forg3/secadora-de-toalha/Esquemático Completo do Secador de Toalhas.png

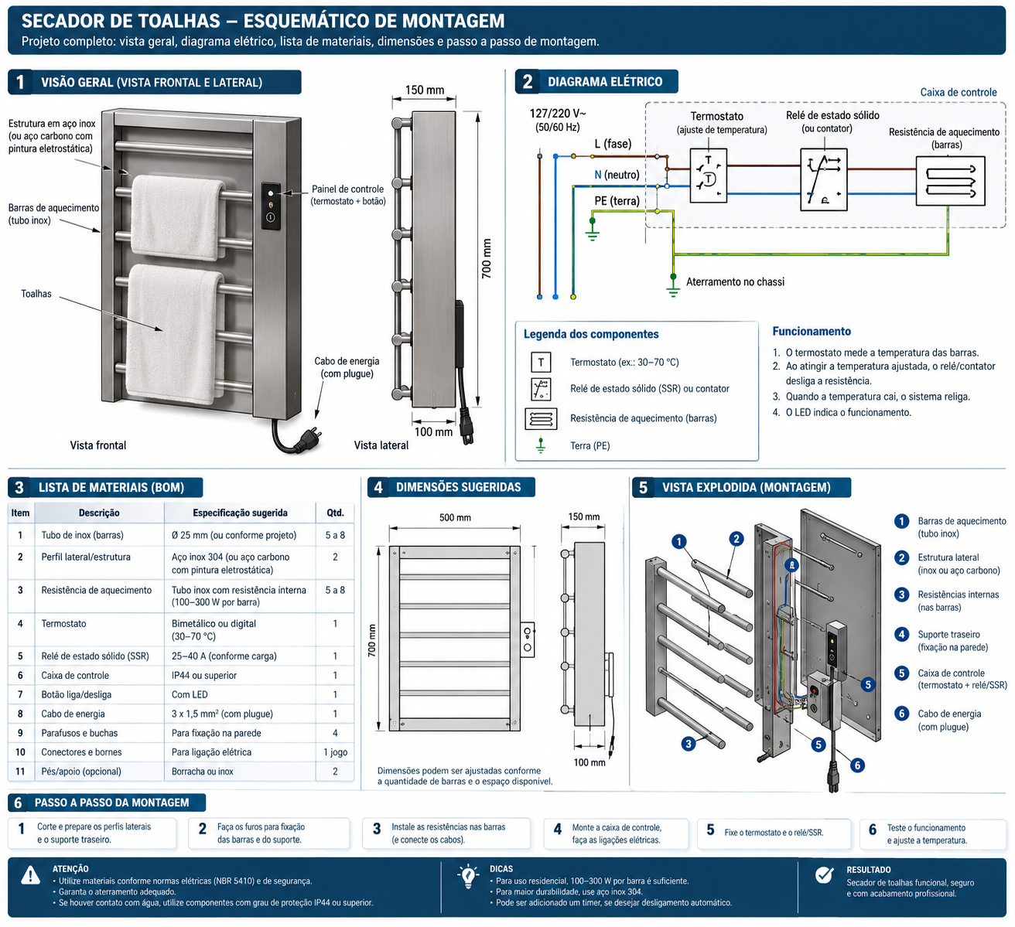
Esquemático Completo do Secador de Toalhas.png
