forg3/secadora-de-toalha/Infográfico Técnico_ Secador de Toalhas.png

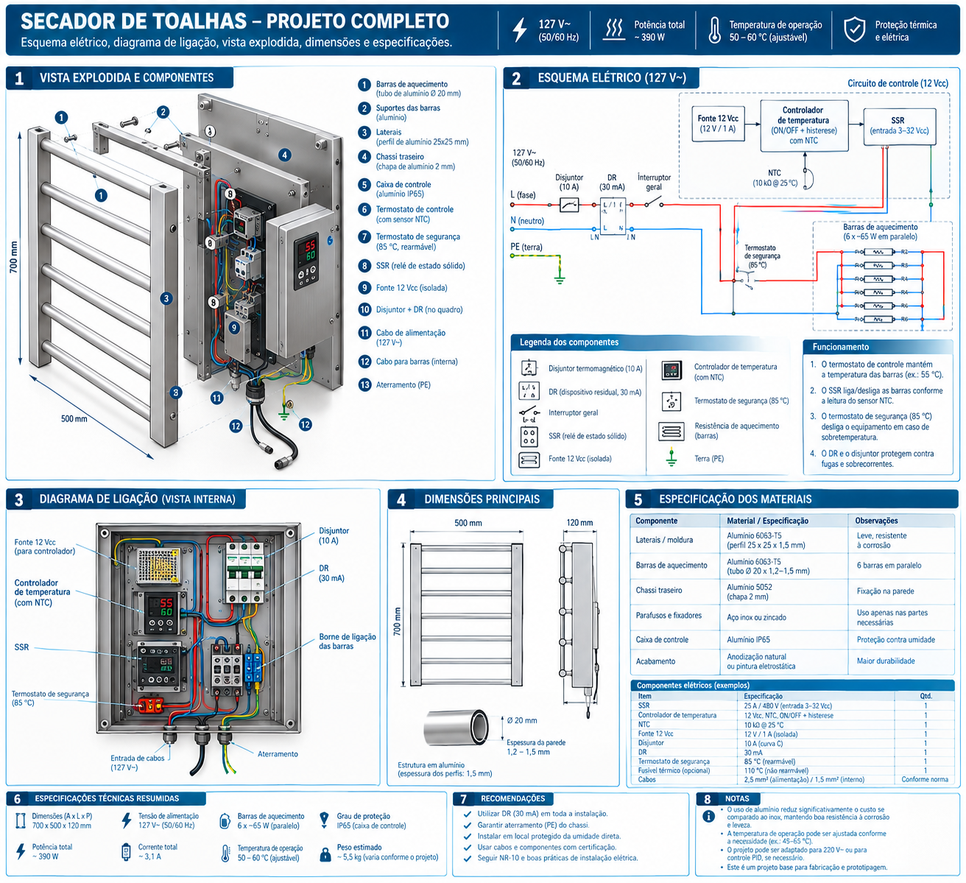
Infográfico Técnico_ Secador de Toalhas.png
