forg3/secadora-de-toalha/ChatGPT Image 12 de set. de 2026, 21_11_23.png

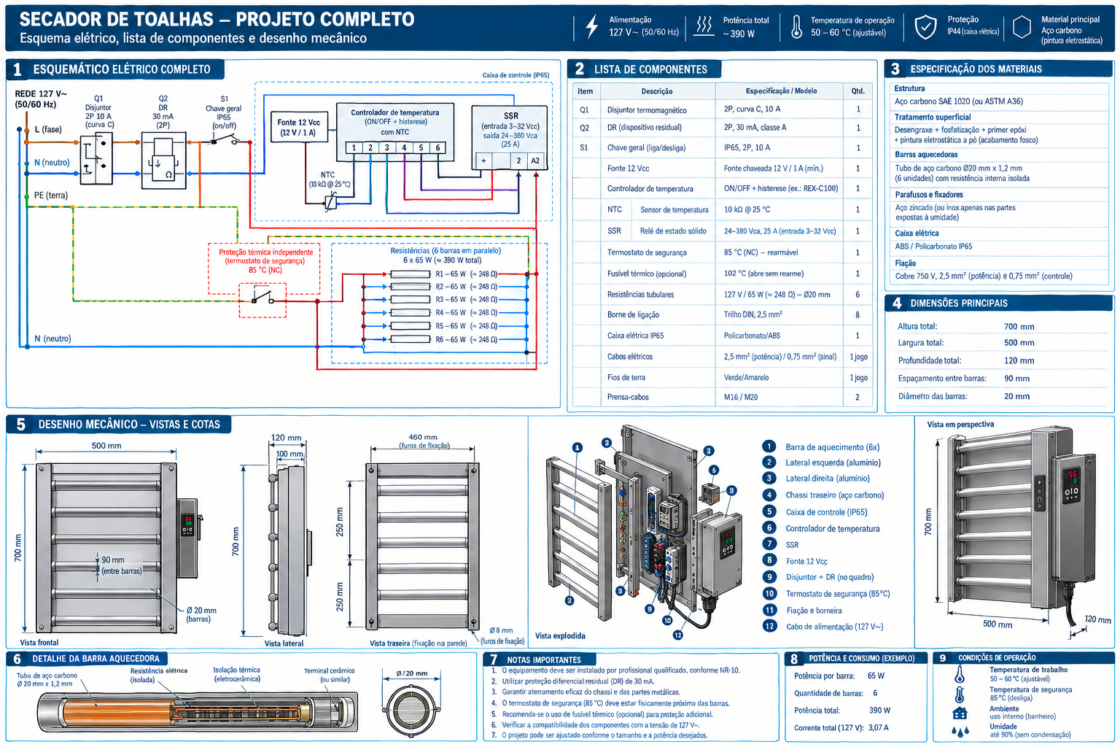
ChatGPT Image 12 de set. de 2026, 21_11_23.png
