forg3/secadora-de-toalha/pcb/top.png

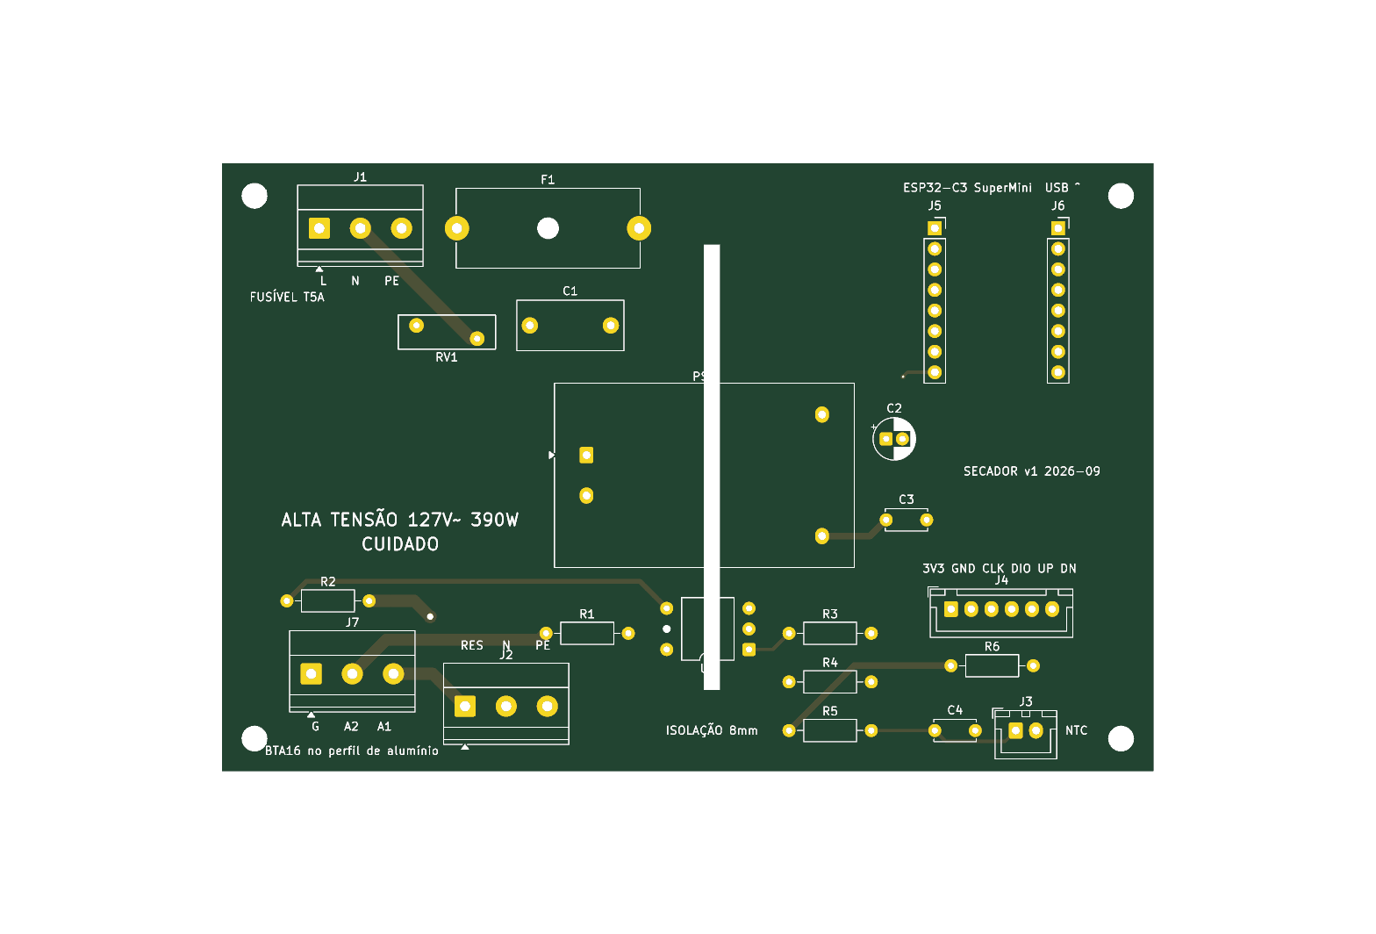
pcb/top.png
