forg3/secadora-de-toalha/pcb/fabricacao/secador-toalha-bom-pcbway.xlsx

Item # | Designator | Qty | Manufacturer | Mfg Part # | Description / Value | Package/Footprint | Type | Your Instructions / Notes
1 | PS1 | 1 | Hi-Link | HLK-PM01 | AC-DC module 100-240VAC to 5VDC 3W isolated | HLK-PMxx THT | THT
2 | U1 | 1 | onsemi | MOC3063TVM | Zero-cross triac optocoupler 600V | DIP-6 0.4in (10.16mm) wide lead | THT | Must be wide-lead (T option). Pin 5 goes into the unplated hole - do not solder it
3 | F1 | 1 | Schurter | 0031.8201 | Fuse holder 5x20mm PCB open | 5x20 horizontal P22.5mm | THT
4 | F1 (fuse) | 1 | Littelfuse | 0218005.HXP | Fuse 5x20mm 5A 250VAC slow-blow | 5x20mm | THT | Insert into F1 holder
5 | RV1 | 1 | TDK | B72214S0271K101 | Varistor S14K275 (14D431K equivalent) | Disc 14mm P7.5mm | THT | Equivalent 14D431K accepted
6 | C1 | 1 | Any | - | Capacitor 100nF 275VAC class X2 | Box P10mm W<=6mm L<=13mm | THT | Safety-rated X2 only
7 | C2 | 1 | Any | - | Aluminium electrolytic 10uF 16V | Radial D5mm P2mm | THT | Observe polarity
8 | C3,C4 | 2 | Any | - | Ceramic 100nF 50V | Disc P5mm | THT
9 | R1 | 1 | Any | - | Resistor 360R 1/4W 1% metal film | Axial DIN0207 P10.16mm | THT
10 | R2 | 1 | Any | - | Resistor 330R 1/4W 1% metal film | Axial DIN0207 P10.16mm | THT
11 | R3 | 1 | Any | - | Resistor 150R 1/4W 1% metal film | Axial DIN0207 P10.16mm | THT
12 | R4,R5,R6 | 3 | Any | - | Resistor 10k 1/4W 1% metal film | Axial DIN0207 P10.16mm | THT
13 | J1,J2,J7 | 3 | Phoenix Contact | 1715734 | Terminal block 3 pos 5.08mm MKDS 1.5/3-5.08 | THT P5.08mm | THT | Wire entry facing board edge as in silkscreen
14 | J3 | 1 | JST | B2B-XH-A(LF)(SN) | Header XH 2 pos 2.5mm vertical | JST XH | THT
15 | J4 | 1 | JST | B6B-XH-A(LF)(SN) | Header XH 6 pos 2.5mm vertical | JST XH | THT
16 | J5,J6 | 2 | Any | - | Female pin header 1x8 2.54mm vertical | 1x08 P2.54mm | THT | Sockets only - ESP32 module is NOT placed
17 | Q1 (off-board) | 1 | STMicroelectronics | BTA16-600BRG | Triac 16A 600V insulated tab | TO-220AB | DNP | Do not place. Ship loose with the boards
18 | J3/J4 mating | 1 | JST | XHP-2 + XHP-6 + SXH-001T-P0.6 x8 | Housings and crimp contacts | - | DNP | Ship loose
