forg3/secadora-de-toalha/pcb/fabricacao/secador-toalha-montagem.pdf

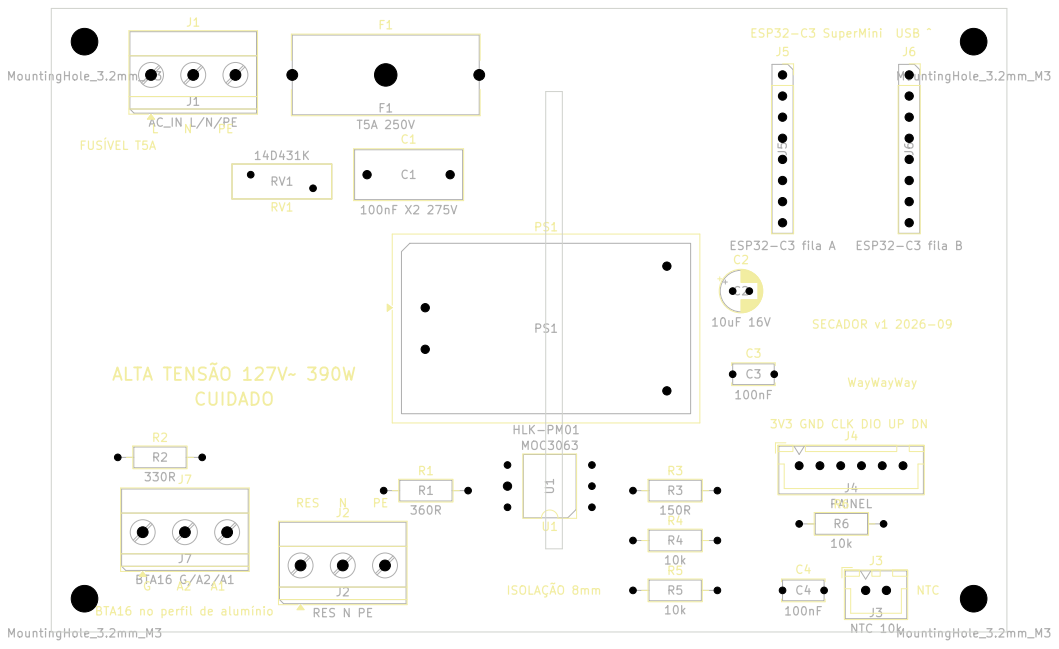
[picture p5: page 1]

ESP32-C3 SuperMini USB ^ 3V3 GND CLK DIO UP DN

SECADOR v1 2026-09 WayWayWayNTC ALTA TENSÃO 127V~ 390W
