forg3/secadora-de-toalha/(list of files, drawings)

Other design files:
pcb/secador-toalha.dsn
