forg3/secadora-de-toalha/pcb/secador-toalha.kicad_pcb

## KiCad design pcb/secador-toalha.kicad_pcb (2026-09-23)

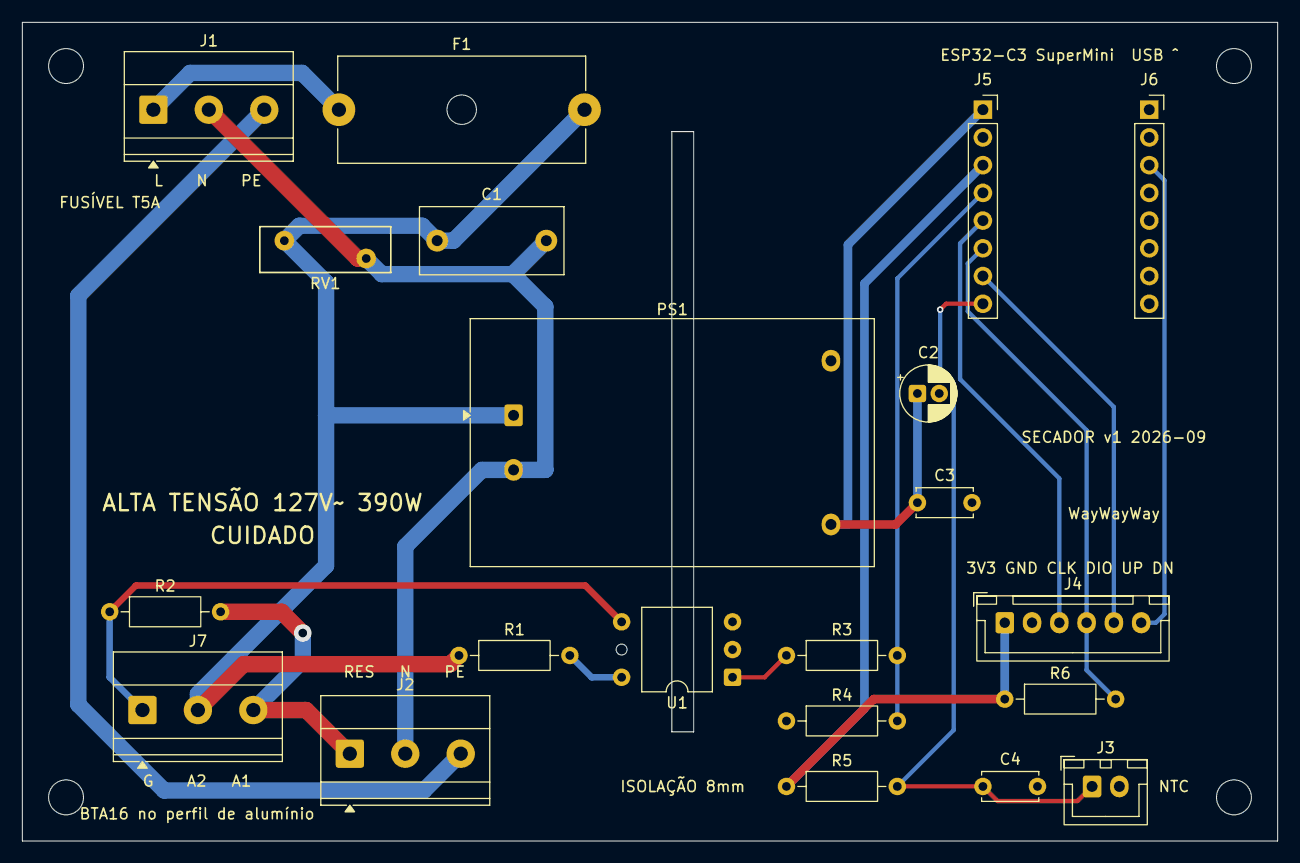
[picture p6: board secador-toalha.kicad_pcb from above]

Board: 2 copper layers, 115.0 x 75.0 mm, 25 parts (0 on the bottom side), 17 nets.

Parts:
C1: 100nF X2 275V; C_Rect_L13.0mm_W6.0mm_P10.00mm_FKS3_FKP3_MKS4
C2: 10uF 16V; CP_Radial_D5.0mm_P2.00mm
C3, C4: 100nF; C_Disc_D5.0mm_W2.5mm_P5.00mm
F1: T5A 250V; Fuseholder_Cylinder-5x20mm_Schurter_0031_8201_Horizontal_Op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
H1, H2, H3, H4: MountingHole_3.2mm_M3
J1: AC_IN L/N/PE; TerminalBlock_Phoenix_MKDS-1,5-3-5.08_1x03_P5.08mm_Horizont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
J2: RES N PE; TerminalBlock_Phoenix_MKDS-1,5-3-5.08_1x03_P5.08mm_Horizont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
J3: NTC 10k; JST_XH_B2B-XH-A_1x02_P2.50mm_Vertical
J4: PAINEL; JST_XH_B6B-XH-A_1x06_P2.50mm_Vertical
J5: ESP32-C3 fila A; PinSocket_1x08_P2.54mm_Vertical
J6: ESP32-C3 fila B; PinSocket_1x08_P2.54mm_Vertical
J7: BTA16 G/A2/A1; TerminalBlock_Phoenix_MKDS-1,5-3-5.08_1x03_P5.08mm_Horizont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
PS1: HLK-PM01; Converter_ACDC_Hi-Link_HLK-PMxx
R1: 360R; R_Axial_DIN0207_L6.3mm_D2.5mm_P10.16mm_Horizontal
R2: 330R; R_Axial_DIN0207_L6.3mm_D2.5mm_P10.16mm_Horizontal
R3: 150R; R_Axial_DIN0207_L6.3mm_D2.5mm_P10.16mm_Horizontal
R4, R5, R6: 10k; R_Axial_DIN0207_L6.3mm_D2.5mm_P10.16mm_Horizontal
RV1: 14D431K; RV_Disc_D12mm_W4.2mm_P7.5mm
U1: MOC3063; DIP-6_W10.16mm

Connections:
+3V3: J4.1, J5.3, R5.1, R6.1
+5V: C2.1, C3.1, J5.1, PS1.4
AC_L: F1.1, J1.1
AC_L_FUSED: C1.1, F1.2, J7.2, PS1.1, R1.1, RV1.1
AC_N: C1.2, J1.2, J2.2, PS1.2, RV1.2
BTN_DN: J4.6, J6.3
BTN_UP: J4.5, J5.7
EARTH_PE: J1.3, J2.3
GND: C2.2, C3.2, C4.2, J3.2, J4.2, J5.2, PS1.3, R4.1, U1.2
HEAT_SW: J2.1, J7.3, R2.2
MOC_LED: R3.1, U1.1
MOC_OUT: R1.2, U1.6
NTC_ADC: C4.1, J3.1, J5.8, R5.2
TM_CLK: J4.3, J5.5
TM_DIO: J4.4, J5.6, R6.2
TRIAC_DRV: J5.4, R3.2, R4.2
TRIAC_GATE: J7.1, R2.1, U1.4
