forg3/secadora-de-toalha/firmware/firmware.ino

// Secador de toalhas — o código está em src/main.cpp (lógica de aquecimento em src/control.h).
// Compilar: arduino-cli compile --fqbn esp32:esp32:esp32c3:CDCOnBoot=cdc .
// Gravar:   arduino-cli upload  --fqbn esp32:esp32:esp32c3:CDCOnBoot=cdc -p /dev/ttyACM0 .
// Biblioteca: arduino-cli lib install "TM1637"
